diogo-leal-da-silva/cockpit-simulator-ffb/docs/modelagem_dados.png

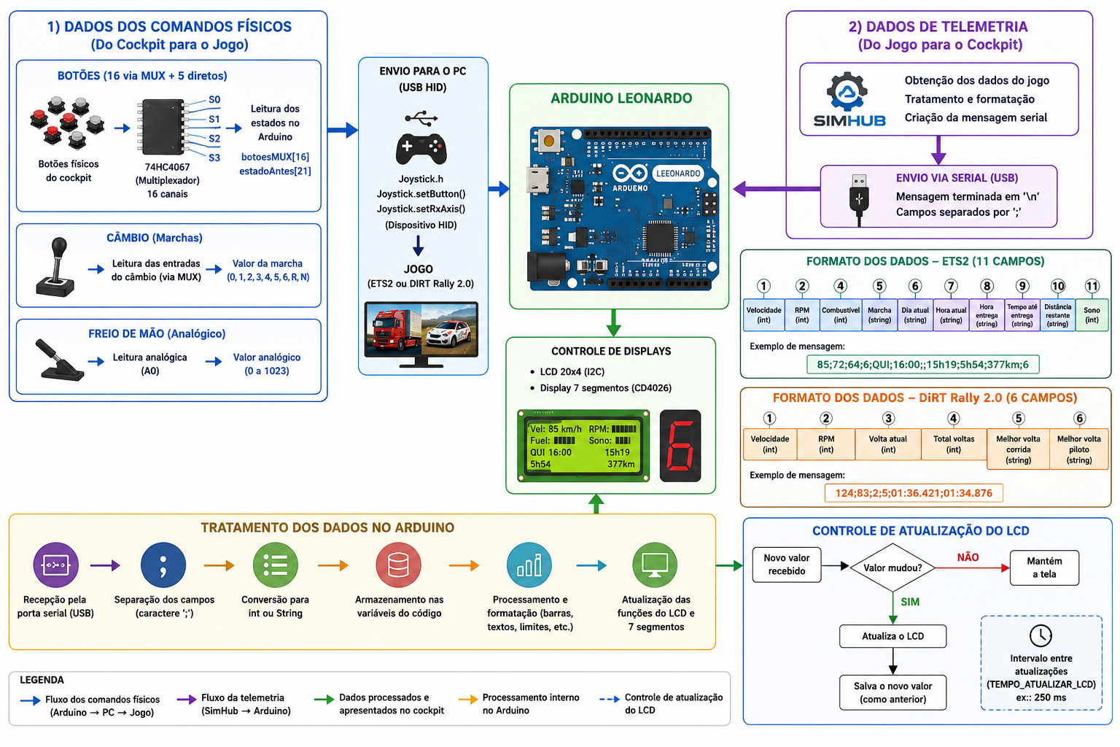
docs/modelagem_dados.png
