diogo-leal-da-silva/cockpit-simulator-ffb/esquemas/MKS_esquematico.png

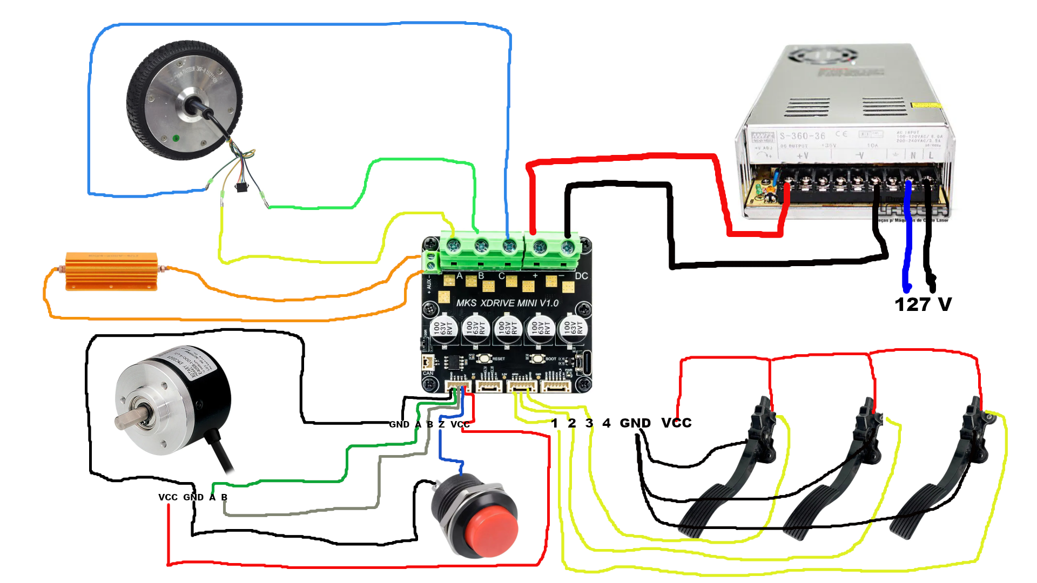
esquemas/MKS_esquematico.png
