diogo-leal-da-silva/cockpit-simulator-ffb/docs/documentacao_principal.md

## Na presente pasta se encontra o documento informativo sobre as motivações e objetivos do projeto, com a apresentação do projeto de comunicação e modelagem de dados, além da explicação do funcionamento base do driver MKS/Odrive. A discussão final virá com os percalços da ideia, suas vantagens e limitações.
