diogo-leal-da-silva/cockpit-simulator-ffb/codigos/codigos.md

## Na seguinte sessão temos um documento de explicação para os códigos e junto temos os códigos de sketch para o Euro Truck Simulator 2 e DiRT Rally 2.0, os jogos que tenho e utilizo.
