diogo-leal-da-silva/cockpit-simulator-ffb/software/software.md

## Nessa área temos o software de compilação e envio de sketchs correspondentes a utilização dos botões e telemetria de algum jogo em específico.
