diogo-leal-da-silva/cockpit-simulator-ffb/esquemas/esquemas.md

## Nesta pasta temos os esquemas elétricos de conexões necessárias para o desenvolvimento das conexões.
