diogo-leal-da-silva/cockpit-simulator-ffb/esquemas/cambio_freio_de_mao_esquematico.png

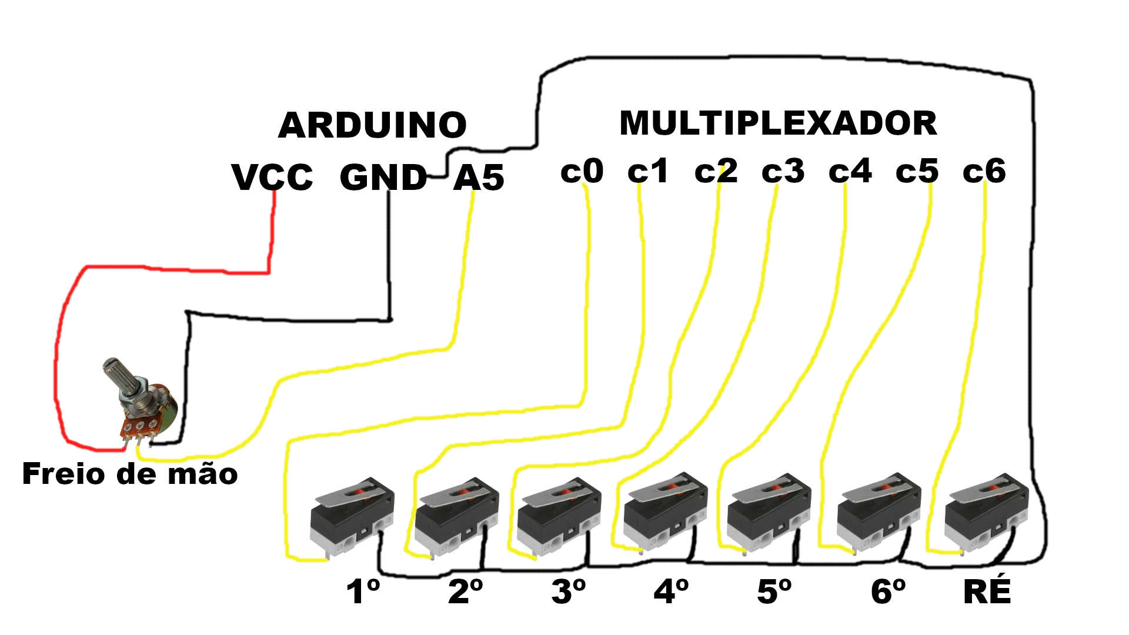
esquemas/cambio_freio_de_mao_esquematico.png
