diogo-leal-da-silva/cockpit-simulator-ffb/esquemas/esquematico_PCB_explicado.png

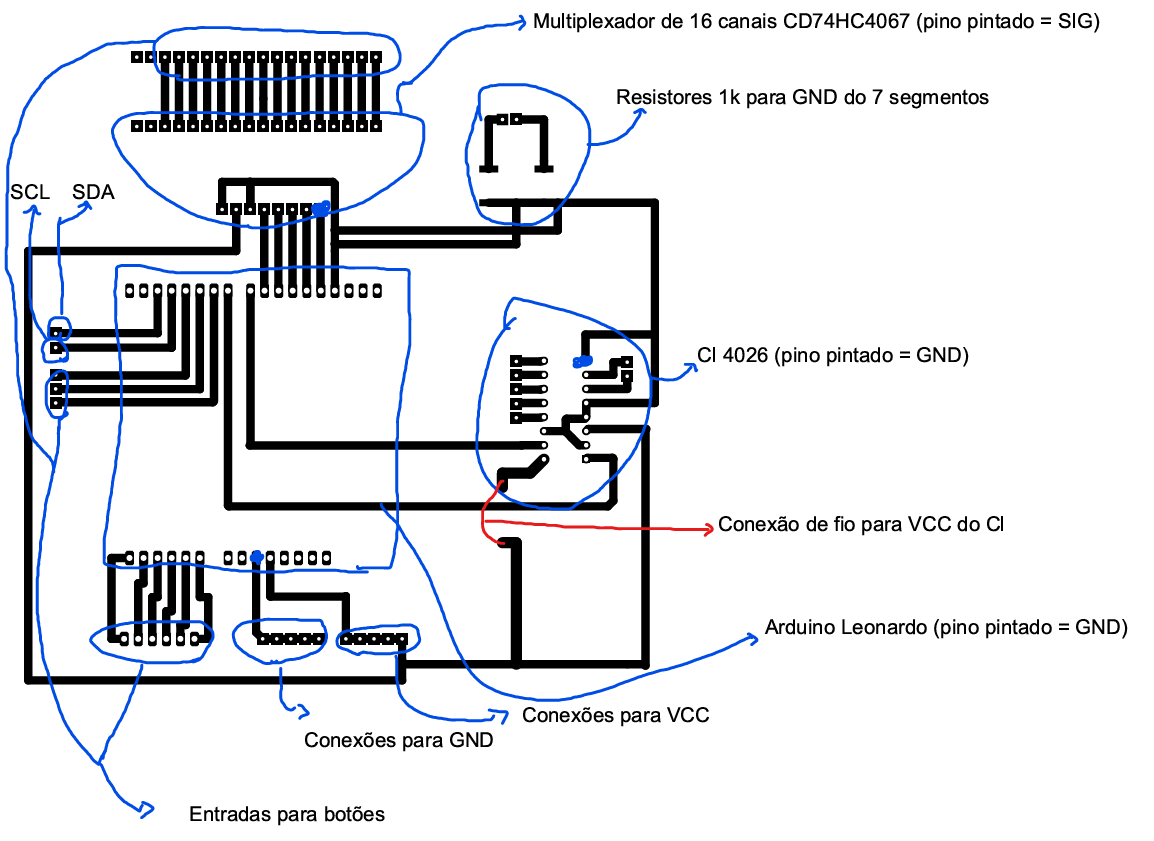
esquemas/esquematico_PCB_explicado.png
