diogo-leal-da-silva/cockpit-simulator-ffb/esquemas/pino_cd4026.png

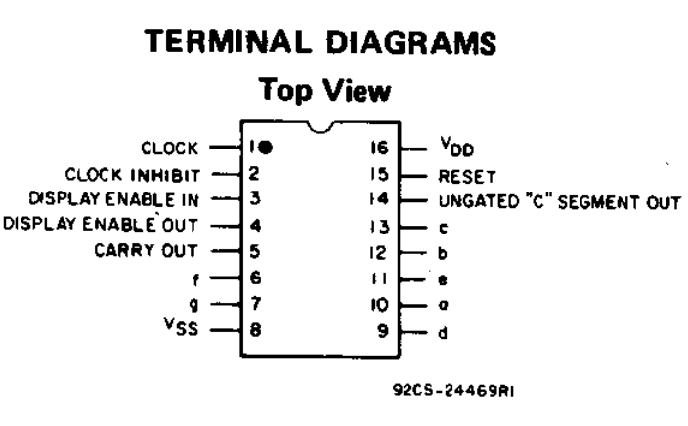
esquemas/pino_cd4026.png
