diogo-leal-da-silva/cockpit-simulator-ffb/esquemas/sinais_74HC4067.png

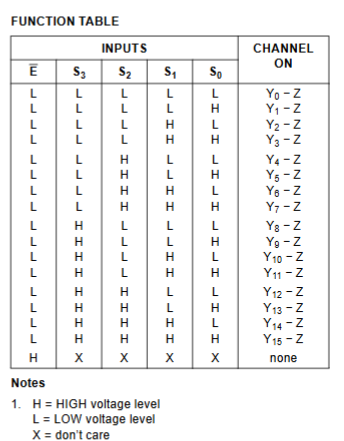
esquemas/sinais_74HC4067.png
