diogo-leal-da-silva/cockpit-simulator-ffb/esquemas/sinais_CD4096.png

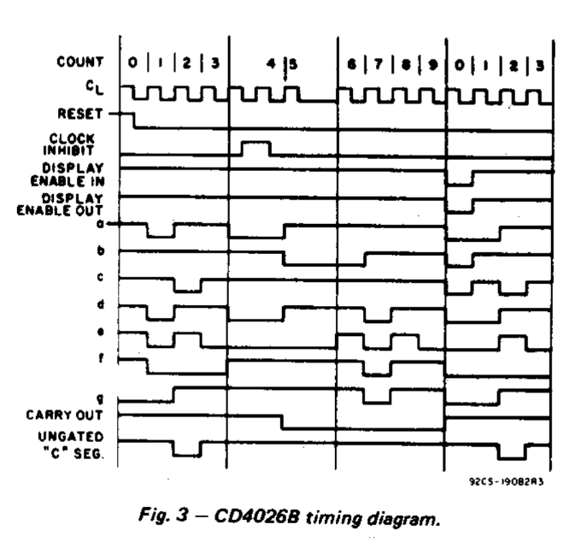
esquemas/sinais_CD4096.png
