diogo-leal-da-silva/cockpit-simulator-ffb/montagem/montagem.md

## Aqui temos um manual de montagem para reprodução através do passo a passo para até o resultado final.
!! EM BREVE !!
