diogo-leal-da-silva/cockpit-simulator-ffb/resultado/resultado.md

## Aqui é o local que fica os resultados, como vídeos explicativos e de funcionamento do simulador, e mais algumas fotos.
!! EM BREVE !!
