diogo-leal-da-silva/cockpit-simulator-ffb/esquemas/esquemático_PCB.pdf

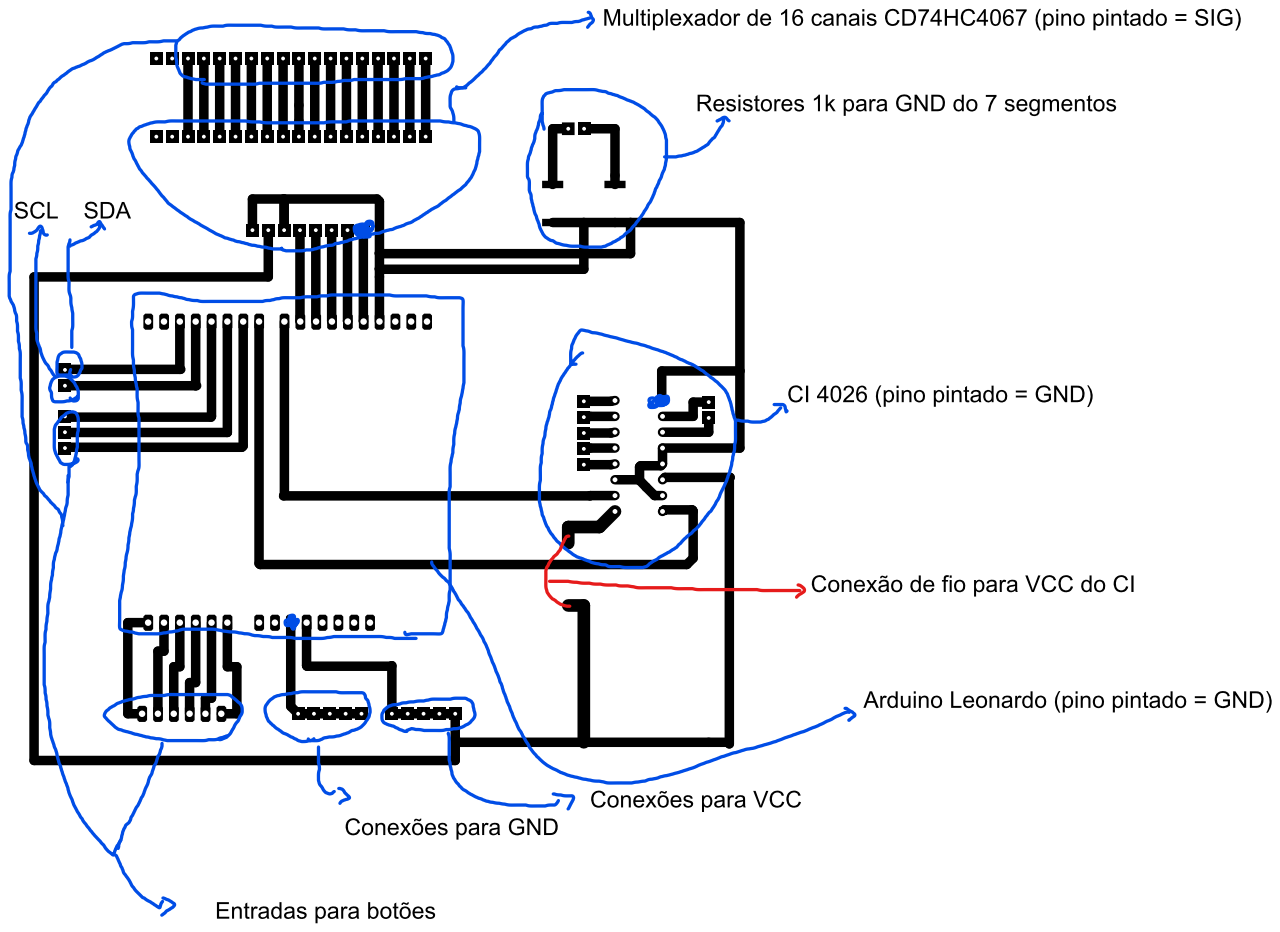
[picture p9: page 1]
